TanmayChhatbar/esp32-can_datalogger/README.md

# ESP32-based CAN Datalogger

https://github.com/user-attachments/assets/50ae6a31-43c1-45fb-a447-b922d48a3503

[More information on YouTube](https://youtu.be/qLKWpdkve9A)

## Idea

- Overall datalogger using CAN
- One CAN for/from the motorcycle, one for/from sensors
- Request signals over OBD from the motorcycle
- Onboard GPS for location and time
- Onboard IMU
- External antenna
- Onboard button cell for hot-starts
- TPMS (for BLE-based sensors)

## Hardware

| Utility | Component |
| --- | --- |
| Microcontroller | ESP32-C6 Supermini |
| CAN Transceiver | TJA1051 (x2) |
| SD card connector | MSD-4-A |
| IMU | ICM-20948 |
| GPS | PA-1616D |

## References

- [cantools](https://github.com/cantools/cantools)
- [MT07_CAN_Project](https://github.com/JackHat1/MT07_CAN_Project)

## Future Work (Suggest)

- Super-capacitor for saving logs on sudden power-cut?
- Revise mounting for reducing engine vibration
- Improved GPS chip

  | Chip                                                                                             | Features                        | Cost  |
  | ------------------------------------------------------------------------------------------------ | ------------------------------- | ----- |
  | [Quectel LC29HCA](https://forums.quectel.com/uploads/short-url/nu6XgBFKtXOYPPegStMeuTfr7L9.pdf)  | dual band, 10hz, DR             | 24.69 |
  | [Quectel LC29HBA](https://forums.quectel.com/uploads/short-url/nu6XgBFKtXOYPPegStMeuTfr7L9.pdf)  | dual band, 10hz, DR, RTK        | 42.73 |
  | [NEO-M9V](https://content.u-blox.com/sites/default/files/NEO-M9V-20B_DataSheet_UBX-21029781.pdf) | single-band, 50hz (with DR), DR | 18.67 |

- Improved IMU

  | Chip                                                                                                                             | Features                   | Cost  |
  | -------------------------------------------------------------------------------------------------------------------------------- | -------------------------- | ----- |
  | [BNO086](https://www.digikey.com/en/products/detail/ceva-technologies-inc/BNO086/14114190)                                       | Updated from 085   | 13.93 |
  | [ICM-45686](https://www.digikey.com/en/products/detail/tdk-invensense/icm-45686/24374985)                                        | TODO               | 5.26  |
  | [IAM-20680HP](https://www.digikey.com/en/products/detail/tdk-invensense/IAM-20680HP/13419974)                                    | Automotive, TODO   | 15.88 |

- Standalone Magnetometer

  | Chip                                                                                                                                                                                                                                                                                                                                                                                                                                         | Features | Cost |
  | -------------------------------------------------------------------------------------------------------------------------------------------------------------------------------------------------------------------------------------------------------------------------------------------------------------------------------------------------------------------------------------------------------------------------------------------- | -------- | ---- |
  | [List](https://www.digikey.com/en/products/filter/magnetic-sensors/linear-compass-ics/554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) | To check | 0.0  |
