TanmayChhatbar/esp32-can_datalogger/kicad/dl/ESP32 C6 Supermini.step

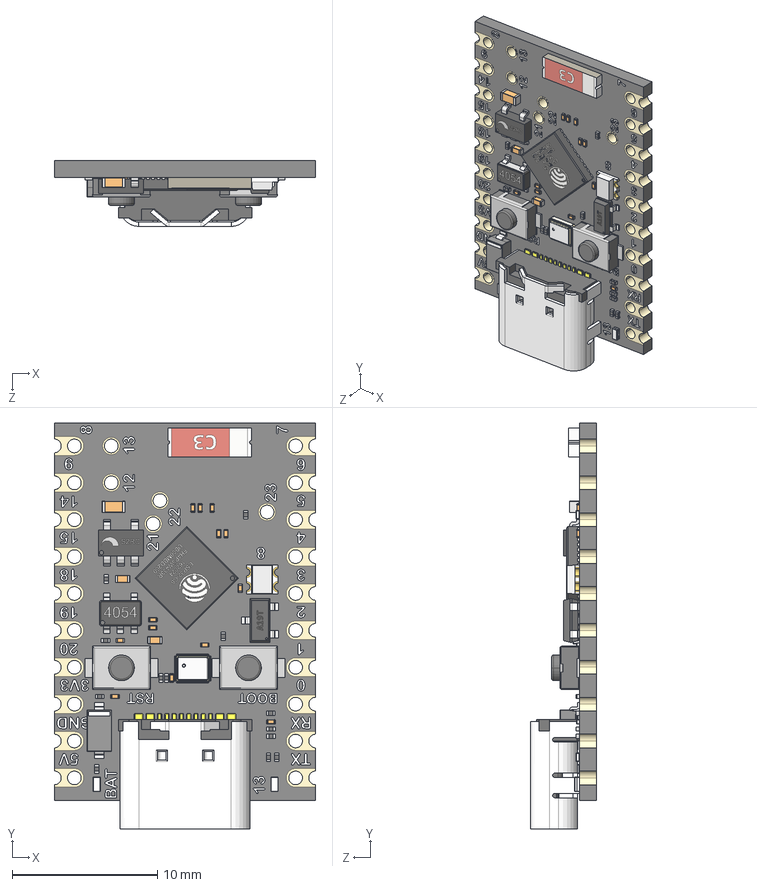
[picture p1: CAD file, 2026-08-05]
kicad/dl/ESP32 C6 Supermini.step
18.0 x 28.0 x 4.54 mm
Light.step x 2
Body.step x 2
Cathode Mark.step x 2
Anode Pin.step x 2
Cathode Pin.step x 2
Base.step x 2
Cathode.step
Anode.step
Cathode Bar.step
Body_1.step
Part 3_2.step x 13
Part 2_2.step x 13
Part 1_2.step x 13
Model.step
Part 3.step x 2
Part 2.step x 2
Part 1.step x 2
Part 3_1.step
Part 2_1.step
Part 1_1.step
Model_1.step
USB_type_C_smd_12p.step
SMD Ceramic Antenna.step
3x4x2mm - 2 button.step x 2
WS2812-2020.step
Yageo-RC0201.step x 13
2520 SMD Crystal Oscillator.step
TP4054-SOT23 v2.step
ME6211-SOT23 v2.step
Top (1).step
Bottom (1).step
Silkscreen (1)-0.step
Silkscreen (1)-1.step
Silkscreen (1)-2.step
Silkscreen (1)-3.step
Silkscreen (1)-4.step
Silkscreen (1)-5.step
Silkscreen (1)-6.step
Silkscreen (1)-7.step
Silkscreen (1)-8.step
Silkscreen (1)-9.step
Silkscreen (1)-10.step
Silkscreen (1)-11.step
Silkscreen (1)-12.step
Silkscreen (1)-13.step
Silkscreen (1)-14.step
Silkscreen (1)-15.step
Silkscreen (1)-16.step
Silkscreen (1)-17.step
Silkscreen (1)-18.step
Silkscreen (1)-19.step
Silkscreen (1)-20.step
Silkscreen (1)-21.step
Silkscreen (1)-22.step
Silkscreen (1)-23.step
Silkscreen (1)-24.step
Silkscreen (1)-25.step
Silkscreen (1)-26.step
Silkscreen (1)-27.step
Silkscreen (1)-28.step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
