TanmayChhatbar/esp32-can_datalogger/kicad/export/datalogger_enclosure - smaller.STEP

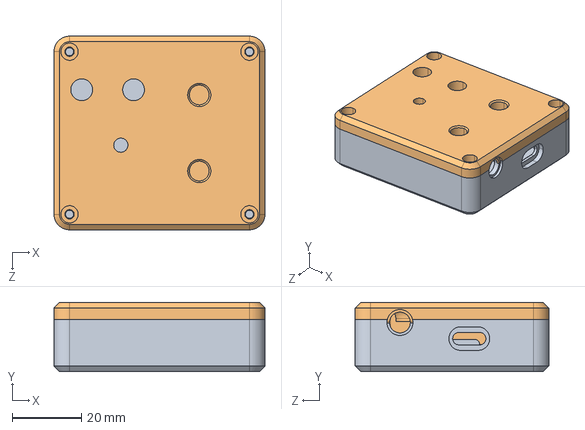
[picture p2: CAD file, 2026-10-13]
kicad/export/datalogger_enclosure - smaller.STEP
61.0 x 20.0 x 56.0 mm
