TanmayChhatbar/esp32-can_datalogger/kicad/export/esp32-can_datalogger.step

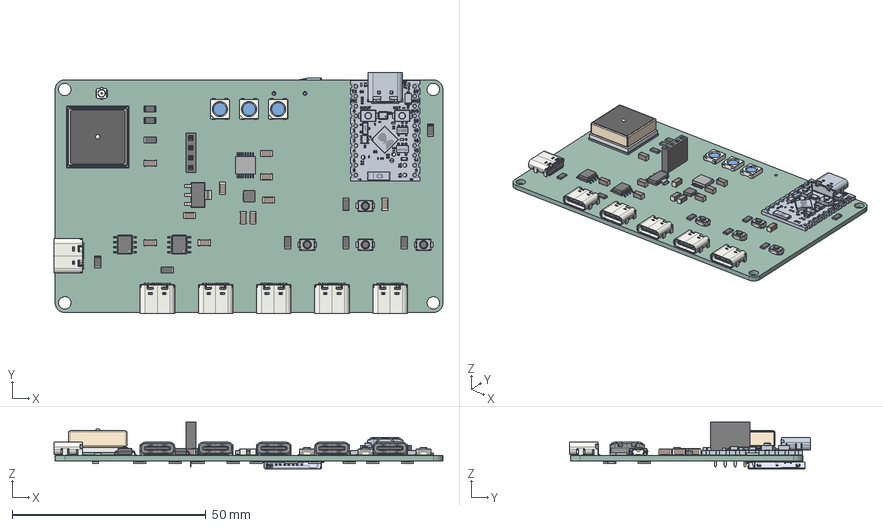
[picture p3: CAD file, 2026-06-27]
kicad/export/esp32-can_datalogger.step
100.3 x 62.0 x 12.1 mm
C_1206_3216Metric x 11
LED_WS2812B_PLCC4_5.0x5.0mm_P3.2mm x 3
QFN-24-1EP_3x3mm_P0.4mm_EP1.75x1.6mm
SOT-223
R_1206_3216Metric x 23
Antenna
Shield
PCB
Pads
SOIC-8_3.9x4.9mm_P1.27mm x 2
USB_C_Receptacle_GCT_USB4105-xx-A_16P_TopMnt_Horizontal x 6
SW_Push_SPST_NO_Alps_SKRK x 4
ESP32 C6 Supermini
U.FL_Hirose_U.FL-R-SMT-1_Vertical
PinSocket_1x04_P2.54mm_Vertical
SOIC_3V204LEX_DIO
MSD-4-A
esp32-can_datalogger_PCB
