TanmayChhatbar/esp32-can_datalogger/kicad/test.md

# hardware to consider

- https://www.digikey.com/en/products/detail/amphenol-sine-systems-corp/ATF13-4P-BM03/10322710
- https://www.digikey.com/en/products/detail/u-blox/NEO-M9V-20B/16611140
