TanmayChhatbar/esp32-can_datalogger/kicad/esp32-can_datalogger.kicad_pcb

## KiCad design kicad/esp32-can_datalogger.kicad_pcb (2026-07-30)

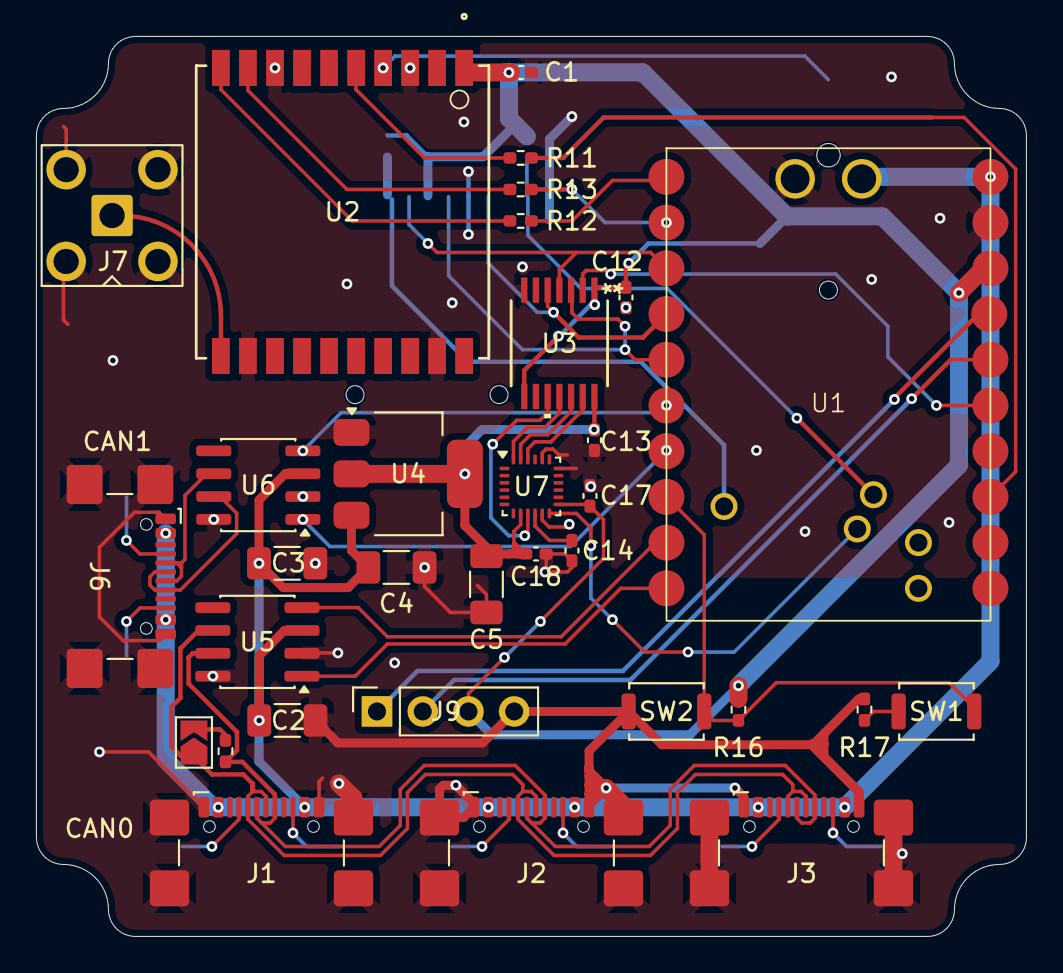
[picture p4: board esp32-can_datalogger.kicad_pcb from above]

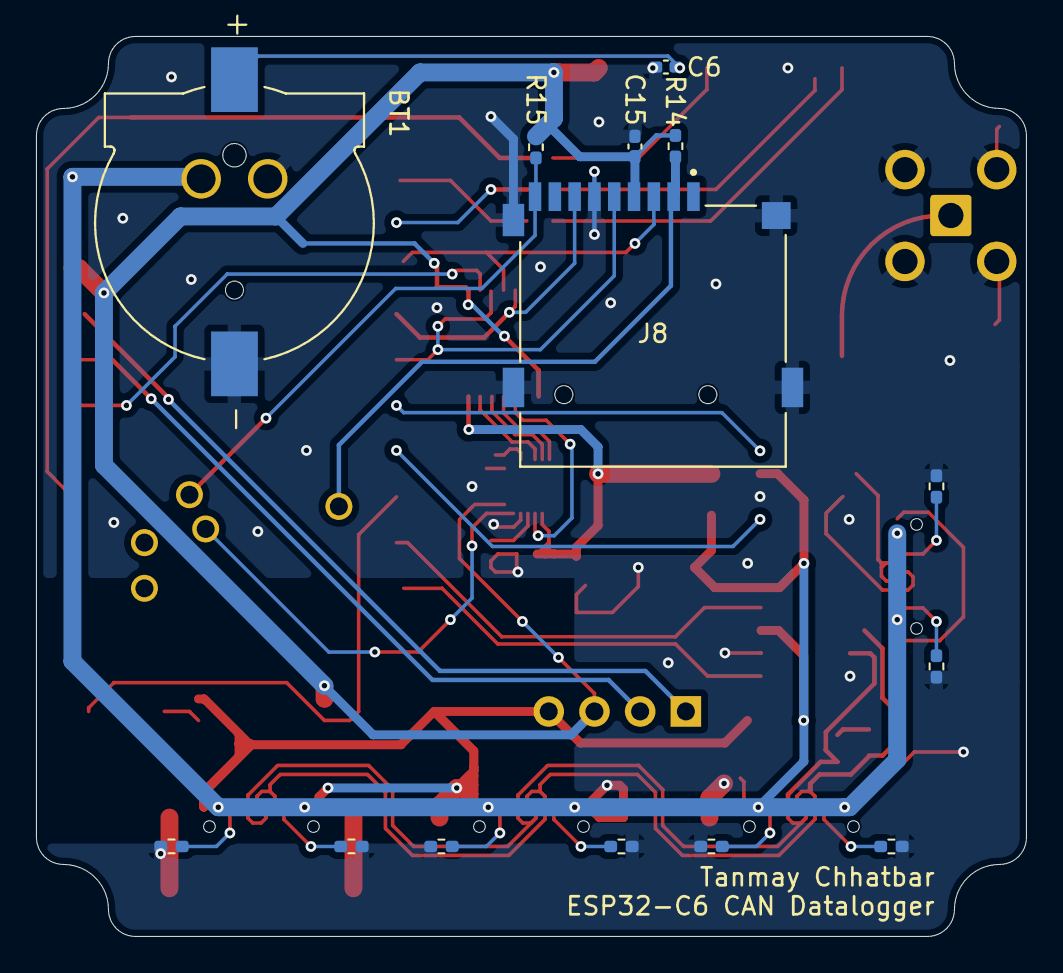
[picture p5: board esp32-can_datalogger.kicad_pcb from below]

Board: 2 copper layers, 55.0 x 50.0 mm, 46 parts (14 on the bottom side), 45 nets.

Parts:
BT1: Battery_Cell; BAT_1056
C1, C6: 1uF; C_0402_1005Metric_Pad0.74x0.62mm_HandSolder
C2, C3: 47uF; C_1206_3216Metric_Pad1.33x1.80mm_HandSolder
C4: 10uF; C_1206_3216Metric_Pad1.33x1.80mm_HandSolder
C5: 22uF; C_1206_3216Metric_Pad1.33x1.80mm_HandSolder
C12, C13, C14, C15, C17, C18: 0.1uF; C_0402_1005Metric_Pad0.74x0.62mm_HandSolder
J1, J2, J3, J6: USB_C_Receptacle_USB2.0_16P; USB_C_Receptacle_GCT_USB4110-grounded shield
J7: Conn_Coaxial; SMA_BAT_Wireless_BWSMA-KWE-Z001
J8: MicroSD; CUI_MSD-4-A
J9: Conn_01x04_Socket; PinSocket_1x04_P2.54mm_Vertical
JP1: SolderJumper_2_Open; SolderJumper-2_P1.3mm_Open_TrianglePad1.0x1.5mm
R1, R2, R4, R5, R7, R8, R9, R10: 5K1; R_0402_1005Metric_Pad0.72x0.64mm_HandSolder
R3: 120; R_0402_1005Metric_Pad0.72x0.64mm_HandSolder
R11, R12, R13: 470; R_0402_1005Metric_Pad0.72x0.64mm_HandSolder
R14, R15, R16, R17: 10K; R_0402_1005Metric_Pad0.72x0.64mm_HandSolder
SW1, SW2: SW_Push; SW_Push_SPST_NO_Alps_SKRK
U1: ESP32-C6 Supermini
U2: PA1616D; CD-PA1616D_ADA
U3: PI4ULS3V204LEX; SOIC_3V204LEX_DIO
U4: AZ1117-1.8; SOT-223-3_TabPin2
U5, U6: TJA1051T; SOIC-8_3.9x4.9mm_P1.27mm
U7: ICM-20948; InvenSense_QFN-24_3x3mm_P0.4mm

Connections:
+1V8: C5.1, C13.1, C18.2, U3.14 (VCCB), U4.2 (VO), U7.8 (VDDIO)
+3.3V: C1.2, C12.2, C15.2, C17.2, J8.4 (VDD), J9.3, R14.2, R15.2, R16.2, U1.18 (3V3), U2.1 (VCC), U3.1 (VCCA), U3.8 (EN), U7.13 (VDD)
+5V: C2.2, C3.2, C4.1, J1.A4 (VBUS), J1.A9 (VBUS), J1.B4 (VBUS), J1.B9 (VBUS), J2.A4 (VBUS), J2.A9 (VBUS), J2.B4 (VBUS), J2.B9 (VBUS), J3.A4 (VBUS), J3.A9 (VBUS), J3.B4 (VBUS), J3.B9 (VBUS), J6.A4 (VBUS), J6.A9 (VBUS), J6.B4 (VBUS), J6.B9 (VBUS), U1.20 (5V), U1.21 (B+), U4.3 (VI), U5.3 (VCC), U6.3 (VCC)
/C0RX: U1.9 (GPIO6), U5.4 (RXD)
/C0TX: U1.10 (GPIO7), U5.1 (TXD)
/C1RX: U1.6 (GPIO3), U6.4 (RXD)
/C1TX: U1.7 (GPIO4), U6.1 (TXD)
/CAN0H: J1.A6 (D+), J1.B6 (D+), J2.A6 (D+), J2.B6 (D+), J3.A6 (D+), J3.B6 (D+), R3.2, U5.7 (CANH)
/CAN0L: J1.A7 (D-), J1.B7 (D-), J2.A7 (D-), J2.B7 (D-), J3.A7 (D-), J3.B7 (D-), JP1.1 (A), U5.6 (CANL)
/CAN1H: J6.A6 (D+), J6.B6 (D+), U6.7 (CANH)
/CAN1L: J6.A7 (D-), J6.B7 (D-), U6.6 (CANL)
/CS_IMU_1V8: U3.13 (B1), U7.22 (~CS)
/MISO_1V8: U3.10 (B4), U7.9 (SDO/AD0)
/MOSI_1V8: U3.11 (B3), U7.24 (SDA/SDI)
/SCK_1V8: U3.12 (B2), U7.23 (SCL/SCLK)
ACC_INT: U1.26 (GPIO22), U7.12 (INT1)
BUTS: R16.1, SW1.1, SW2.1, U1.8 (GPIO5)
CS_IMU: U1.15 (GPIO18), U3.2 (A1)
CS_SD: J8.2 (CD/DAT3), R14.1, U1.27 (GPIO23)
GND: BT1.2 (-), C1.1, C2.1, C3.1, C4.2, C5.2, C6.2, C12.1, C13.2, C14.1, C15.1, C17.1, C18.1, J1.A1 (GND), J1.A12 (GND), J1.B1 (GND), J1.B12 (GND), J1.S1 (SHIELD), J2.A1 (GND), J2.A12 (GND), J2.B1 (GND), J2.B12 (GND), J2.S1 (SHIELD), J3.A1 (GND), J3.A12 (GND), J3.B1 (GND), J3.B12 (GND), J3.S1 (SHIELD), J6.A1 (GND), J6.A12 (GND), J6.B1 (GND), J6.B12 (GND), J6.S1 (SHIELD), J7.2 (Ext), J8.6 (VSS), J8.G1 (COVER_GND), J8.G2 (COVER_GND__1), J8.G3 (COVER_GND__2), J8.G4 (COVER_GND__3), J9.4, R1.2, R2.2, R4.2, R5.2, R7.2, R8.2, R9.2, R10.2, R17.1, SW2.2, U1.19 (GND), U1.22 (B-), U2.3 (GND), U2.8 (GND), U2.12 (GND), U2.19 (GND), U3.7 (GND), U4.1 (GND), U5.2 (GND), U5.8 (S), U6.2 (GND), U6.8 (S), U7.11 (FSYNC), U7.18 (GND), U7.20 (GND)
GPS_FIX: R11.2, U1.13 (GPIO14)
GPS_RX: R12.2, U1.1 (TX)
GPS_TX: R13.2, U1.2 (RX)
I2C_SCK: J9.2, U1.16 (GPIO19)
I2C_SDA: J9.1, U1.17 (GPIO20)
MISO: J8.7 (DAT0), U1.4 (GPIO1), U3.5 (A4)
MOSI: J8.3 (CMD), U1.3 (GPIO0), U3.4 (A3)
unnamed: J1.A5 (CC1), R2.1
unnamed: J1.B5 (CC2), R1.1
unnamed: J2.A5 (CC1), R4.1
unnamed: J2.B5 (CC2), R5.1
unnamed: J3.A5 (CC1), R7.1
unnamed: J3.B5 (CC2), R8.1
unnamed: J6.A5 (CC1), R9.1
unnamed: J6.B5 (CC2), R10.1
unnamed: J7.1 (In), U2.11 (EX_ANT)
unnamed: JP1.2 (B), R3.1
unnamed: R17.2, SW1.2
unnamed: R11.1, U2.5 (3D-FIX)
unnamed: R12.1, U2.10 (RX0)
unnamed: R13.1, U2.9 (TX0)
unnamed: C14.2, U7.10 (REGOUT)
SCK: J8.5 (CLK), U1.5 (GPIO2), U3.3 (A2)
SD_CD: J8.CD, R15.1, U1.25 (GPIO21)
VBACKUP: BT1.1 (+), C6.1, U2.4 (VBACKUP)
