TanmayChhatbar/esp32-can_datalogger/(commit log)

2026-04-19 kicad init
2026-06-07 experimental changes for ESP32-C6 and two CAN buses
2026-06-07 init gps, imu, sd card files
2026-06-07 switch to esp32-c6
2026-06-08 add gps, imu to board schematic
2026-06-08 add footprints, change to bidir TTL, make connections on c6
2026-06-08 pcb updates
2026-06-08 pcb update
2026-06-14 switch RX-TX for GPS
2026-06-17 modify definitions based on board design
2026-06-17 led bringup
2026-06-17 change SPI and I2C pins to remove conflict on compile
2026-06-19 update project for esp32c6
2026-06-19 placeholders for GPS, IMU, SD
2026-06-20 savvycan frame sender defs for obd
2026-06-20 can print to serial like savvycan logs
2026-06-20 matlab gear estimation trial
2026-06-20 run1 - probably useless run2 - gear estimation through gears
2026-06-25 comment out esp32-s3 config
2026-06-25 savvycan utils. dbc, frame sender defs
2026-06-27 add step files for sd card reader and esp32c6
2026-06-30 only serial print in main
2026-07-01 LED - use onboard led, handle led in loop
2026-07-01 remove led toggle test
2026-07-02 led on boot
2026-07-02 remove dependency on ESP32-TWAI-CAN library. use espressif lib for twai directly
2026-07-03 button lib works
2026-07-03 button lib works in code
2026-07-03 button cleanup
2026-07-03 LED change colors, freq for start and stop
2026-07-03 move default to end of switch-case
2026-07-07 sd logger to frame_t
2026-07-07 gps to frame_t
2026-07-07 switch to log_frame_t instead of twai_frame_t
2026-07-07 switch to log_frame_t in sd_logger
2026-07-08 imu bringup
2026-07-08 imu to can works
2026-07-08 imu log file test
2026-07-08 higher resolution imu data in 2 frames
2026-07-08 option to print to serial
2026-07-09 dont print all sigs to serial
2026-07-09 option to not print serial requests
2026-07-09 led instant response for no-blink states
2026-07-10 led handler to vTask, and bugfix for normal operation when serial not connected
2026-07-10 acc, gyro units bug fix
2026-07-10 print imu over serial for plotjuggler
2026-07-11 make LED red when CAN message is received
2026-07-11 make pcb smaller
2026-07-14 update layout and schematic
2026-07-14 update export files for smaller kicad
2026-07-14 update pin definitions
2026-07-29 bad logs from track day
2026-07-29 analog button to be tested
2026-07-29 analog button works
2026-08-01 switch to neopixel to reduce memory
2026-08-05 show different led state when OBD replies detected
2026-08-05 cleanup schematic for ss
2026-08-13 remove override LED to show OBD reception
2026-08-14 add magnetometer list todo
2026-08-18 add options for imu
2026-08-23 button changes
2026-10-13 TPMS sensor identification (python)
2026-10-13 easier serial prints
2026-10-13 add enclosure step file
